Jetorific/modularFeedbackProcessor/README.md

# modularFeedbackProcessor
A Eurorack module that delays audio and allows the user to have their own custom effects in the feedback path. All analog design.
