Jetorific/modularFeedbackProcessor/modularFeedbackProcessor/modularFeedbackProcessor.kicad_pcb

## KiCad design modularFeedbackProcessor/modularFeedbackProcessor.kicad_pcb (2026-04-29)

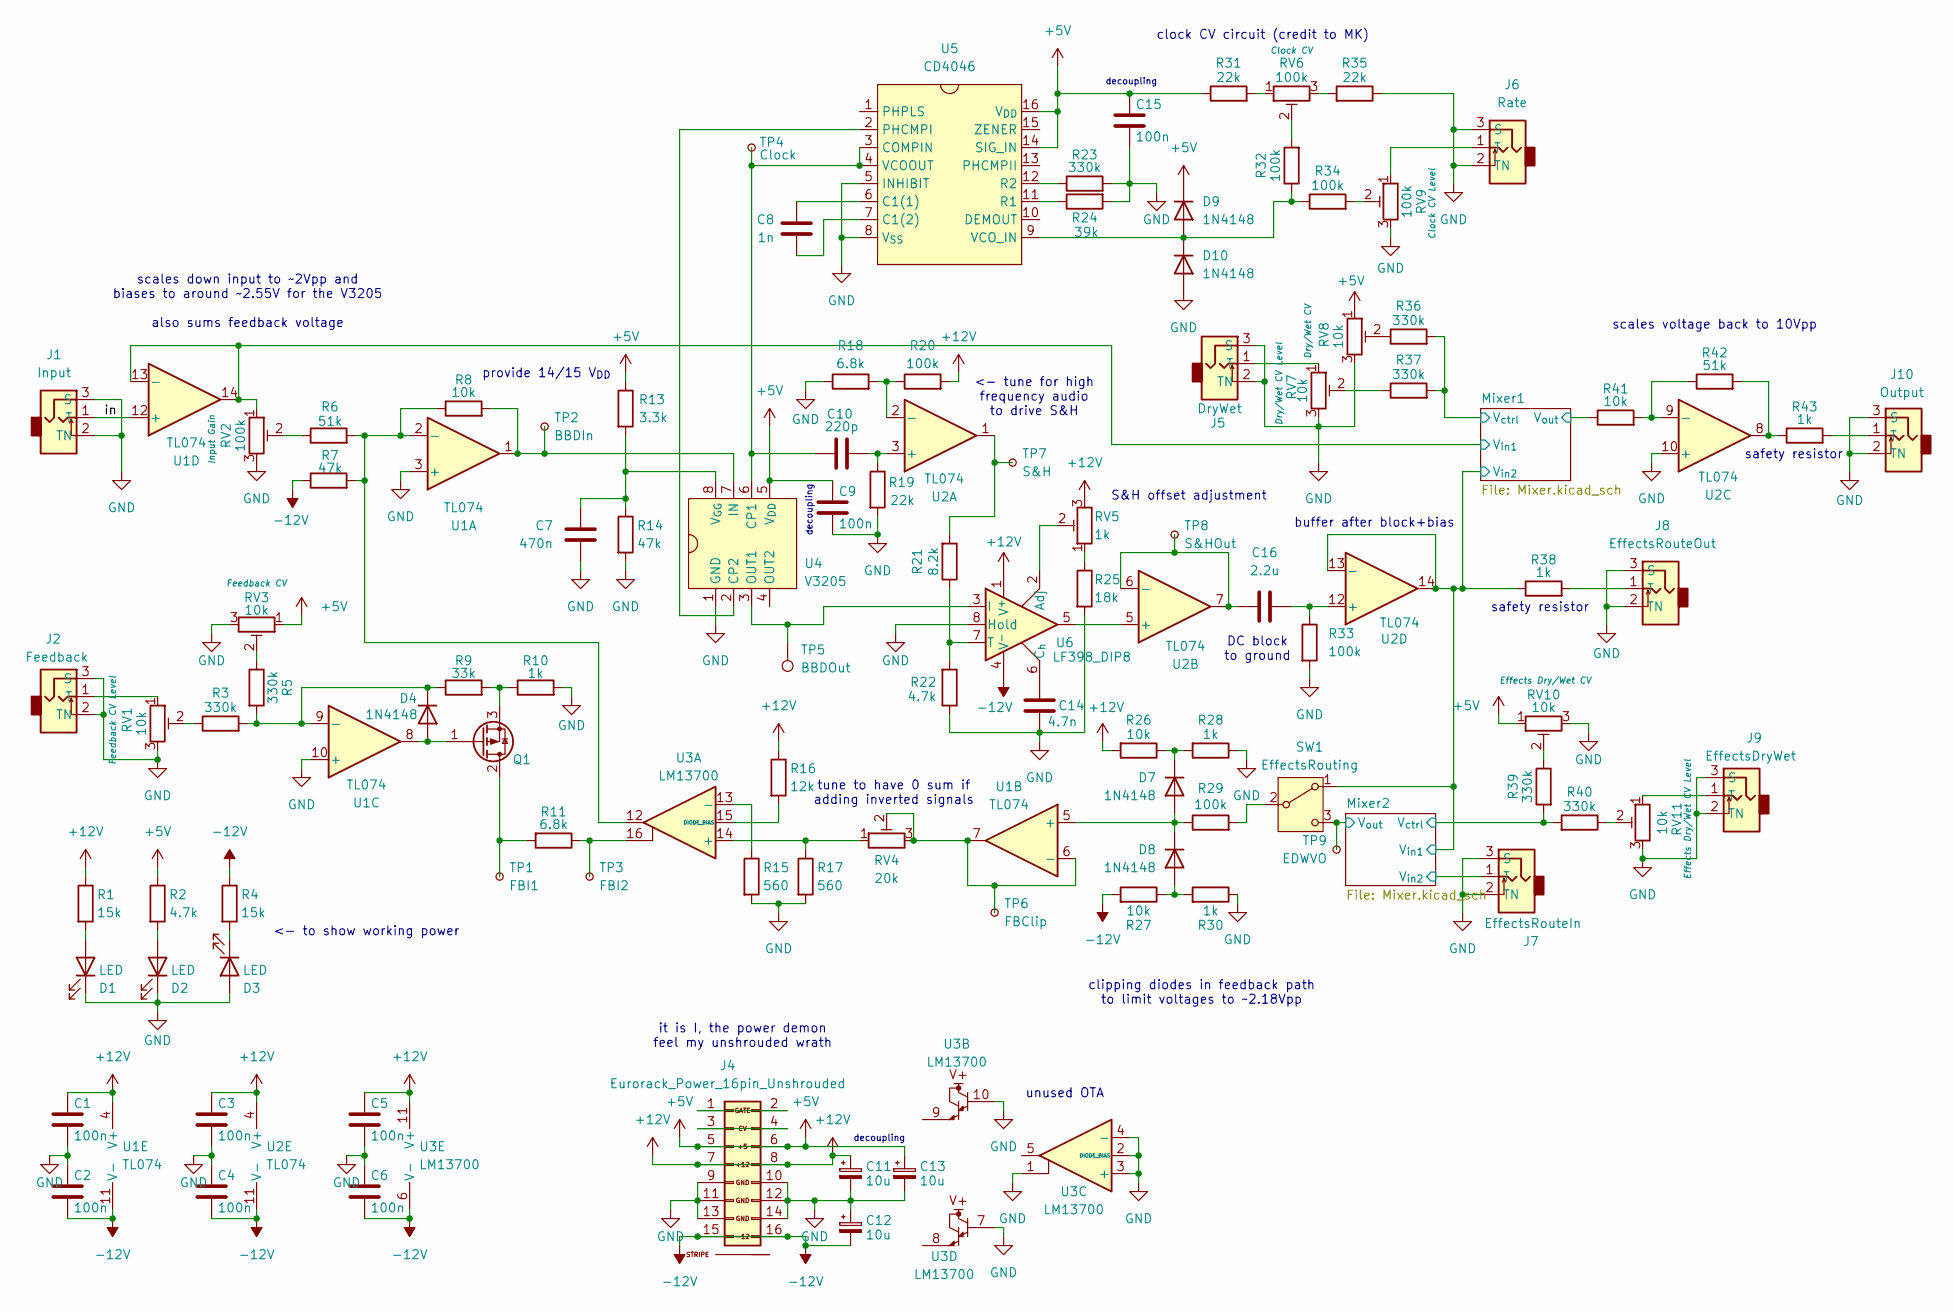
[picture p4: schematic modularFeedbackProcessor.kicad_sch, Modular Feedback Processor]

Parts:
C1, C2, C3, C4, C5, C6, C9, C15: 100n; C_0805_2012Metric_Pad1.18x1.45mm_HandSolder
C7: 470n; C_0805_2012Metric_Pad1.18x1.45mm_HandSolder
C8: 1n; C_0805_2012Metric_Pad1.18x1.45mm_HandSolder
C10: 220p; C_0805_2012Metric_Pad1.18x1.45mm_HandSolder
C11, C12, C13: 10u; CP_Radial_D5.0mm_P2.00mm
C14: 4.7n; C_0805_2012Metric_Pad1.18x1.45mm_HandSolder
C16: 2.2u; C_0805_2012Metric_Pad1.18x1.45mm_HandSolder
D1, D2, D3: LED; LED_D5.0mm
D4, D7, D8, D9, D10: 1N4148; D_DO-35_SOD27_P7.62mm_Horizontal
J1: Input; PJ301M-12
J2: Feedback; PJ301M-12
J4: Eurorack_Power_16pin_Unshrouded; Pins_2x08_2.54mm_TH_EuroPower; Part Number 1-1602FBV0T
J5: DryWet; PJ301M-12
J6: Rate; PJ301M-12
J7: EffectsRouteIn; PJ301M-12
J8: EffectsRouteOut; PJ301M-12
J9: EffectsDryWet; PJ301M-12
J10: Output; PJ301M-12
Q1: Q_PMOS_GDS; TO-220-3_Vertical
R1, R4: 15k; R_0805_2012Metric_Pad1.20x1.40mm_HandSolder
R2, R22: 4.7k; R_0805_2012Metric_Pad1.20x1.40mm_HandSolder
R3, R5, R23, R36, R37, R39, R40: 330k; R_0805_2012Metric_Pad1.20x1.40mm_HandSolder
R6, R42: 51k; R_0805_2012Metric_Pad1.20x1.40mm_HandSolder
R7, R14: 47k; R_0805_2012Metric_Pad1.20x1.40mm_HandSolder
R8, R26, R27, R41: 10k; R_0805_2012Metric_Pad1.20x1.40mm_HandSolder
R9: 33k; R_0805_2012Metric_Pad1.20x1.40mm_HandSolder
R10, R28, R30, R38, R43: 1k; R_0805_2012Metric_Pad1.20x1.40mm_HandSolder
R11, R18: 6.8k; R_0805_2012Metric_Pad1.20x1.40mm_HandSolder
R13: 3.3k; R_0805_2012Metric_Pad1.20x1.40mm_HandSolder
R15, R17: 560; R_0805_2012Metric_Pad1.20x1.40mm_HandSolder
R16: 12k; R_0805_2012Metric_Pad1.20x1.40mm_HandSolder
R19, R31, R35: 22k; R_0805_2012Metric_Pad1.20x1.40mm_HandSolder
R20, R29, R32, R33, R34: 100k; R_0805_2012Metric_Pad1.20x1.40mm_HandSolder
R21: 8.2k; R_0805_2012Metric_Pad1.20x1.40mm_HandSolder
R24: 39k; R_0805_2012Metric_Pad1.20x1.40mm_HandSolder
R25: 18k; R_0805_2012Metric_Pad1.20x1.40mm_HandSolder
RV1, RV3, RV7, RV8, RV10, RV11: 10k; Alpha9mmPot
RV2, RV6, RV9: 100k; Alpha9mmPot
RV4: 20k; Potentiometer_Vishay_T73XW_Horizontal
RV5: 1k; Potentiometer_Vishay_T73XW_Horizontal
SW1: EffectsRouting; Switch_Toggle_SPDT_SubMini
TP1: FBI1; TestPoint_Pad_06
TP2: BBDIn; TestPoint_Pad_06
TP3: FBI2; TestPoint_Pad_06
TP4: Clock; TestPoint_Pad_06
TP5: BBDOut; TestPoint_Pad_06
TP6: FBClip; TestPoint_Pad_06
TP7: S&H; TestPoint_Pad_06
TP8: S&HOut; TestPoint_Pad_06
TP9: EDWVO; TestPoint_Pad_06
U1, U2: TL074; DIP-14_W7.62mm_LongPads
U3: LM13700; DIP-16_W7.62mm_LongPads
U4: V3205; DIP-14_W7.62mm_LongPads_8pin
U5: CD4046; DIP-16_W7.62mm_LongPads
U6: LF398_DIP8; DIP-8_W7.62mm

Connections:
+5V: C9.1, C13.1, C15.1, D9.1 (K), J4.5 (+12V), J4.6, R2.1, R13.1, R31.1, RV3.1, RV8.1, RV10.1, U4.5 (V_{DD}), U5.14 (SIG_IN), U5.16 (V_{DD})
+12V: C1.1, C3.1, C5.1, C11.1, J4.7 (12V), J4.8 (+12V), R1.1, R16.1, R20.2, R26.2, RV5.3, U1.4 (V+), U2.4 (V+), U3.11 (V+), U6.1 (V^{+}); also elsewhere on the board
-12V: C2.2, C4.2, C6.2, C12.2, J4.15 (-12V), J4.16, R4.1, R7.1, R27.2, U1.11 (V-), U2.11 (V-), U3.6 (V-), U6.4 (V^{-}); also elsewhere on the board
/Mixer1/V_{ctrl}: R36.2, R37.2; also elsewhere on the board
/Mixer1/V_{in1}: RV2.1, U1.13 (-), U1.14; also elsewhere on the board
/Mixer1/V_{in2}: R38.1, SW1.1 (A), U2.13 (-), U2.14; also elsewhere on the board
/Mixer1/V_{out}: R41.1; also elsewhere on the board
/Mixer2/V_{ctrl}: R39.2, R40.2; also elsewhere on the board
/Mixer2/V_{in2}: J7.1 (T); also elsewhere on the board
/Mixer2/V_{out}: SW1.3 (C), TP9.1 (1_1); also elsewhere on the board
/in: J1.1 (T), U1.12 (+)
GND: C1.2, C2.1, C3.2, C4.1, C5.2, C6.1, C7.2, C9.2, C11.2, C12.1, C13.2, C14.2, C15.2, D1.1 (K), D2.1 (K), D3.2 (A), D10.2 (A), J1.2 (TN), J1.3 (S), J2.2 (TN), J2.3 (S), J4.9 (GND), J4.10 (GND), J4.11 (GND), J4.12 (GND), J4.13 (-12), J4.14 (-12V), J5.2 (TN), J5.3 (S), J6.2 (TN), J6.3 (S), J7.2 (TN), J7.3 (S), J8.2 (TN), J8.3 (S), J9.2 (TN), J9.3 (S), J10.2 (TN), J10.3 (S), R10.2, R14.2, R15.2, R17.2, R18.1, R19.2, R22.1, R23.2, R24.2, R25.2, R28.1, R30.1, R33.2, R35.1, RV1.3, RV2.3, RV3.3, RV7.3, RV8.3, RV9.3, RV10.3, RV11.3, U1.3 (+), U1.10 (+), U2.10 (+), U3.1, U3.2 (DIODE_BIAS), U3.3 (+), U3.4 (-), U3.7, U3.10, U4.1 (GND), U5.5 (INHIBIT), U5.8 (V_{SS}), U6.8 (Hold); also elsewhere on the board
unnamed: D1.2 (A), R1.2
unnamed: D2.2 (A), R2.2
unnamed: D3.1 (K), R4.2
unnamed: D4.2 (A), Q1.1 (G), U1.8
unnamed: D4.1 (K), R3.2, R5.2, R9.1, U1.9 (-)
unnamed: D7.2 (A), D8.1 (K), R29.1, U1.5 (+)
unnamed: D7.1 (K), R26.1, R28.2
unnamed: D8.2 (A), R27.1, R30.2
unnamed: D9.2 (A), D10.1 (K), R32.1, R34.1, U5.9 (VCO_IN)
unnamed: J2.1 (T), RV1.1
unnamed: J4.1, J4.2
unnamed: J4.3, J4.4
unnamed: J5.1 (T), RV7.1
unnamed: J6.1 (T), RV9.1
unnamed: J8.1 (T), R38.2
unnamed: J9.1 (T), RV11.1
unnamed: J10.1 (T), R43.2
unnamed: Q1.2 (D), R11.2, TP1.1 (1_1)
unnamed: Q1.3 (S), R9.2, R10.1
unnamed: R3.1, RV1.2
unnamed: R5.1, RV3.2
unnamed: R6.1, RV2.2
unnamed: R11.1, TP3.1 (1_1), U3.16
unnamed: R21.2, TP7.1 (1_1), U2.1
unnamed: R25.1, RV5.1
unnamed: R31.2, RV6.1
unnamed: R32.2, RV6.2
unnamed: R34.2, RV9.2
unnamed: R35.2, RV6.3
unnamed: R36.1, RV8.2
unnamed: R37.1, RV7.2
unnamed: R39.1, RV10.2
unnamed: R40.1, RV11.2
unnamed: R42.2, R43.1, U2.8
unnamed: R29.2, SW1.2 (B)
unnamed: R6.2, R7.2, R8.1, U1.2 (-), U3.12
unnamed: RV4.2, RV4.3, TP6.1 (1_1), U1.6 (-), U1.7
unnamed: C10.2, R19.1, U2.3 (+)
unnamed: R18.2, R20.1, U2.2 (-)
unnamed: U2.5 (+), U6.5
unnamed: C16.2, TP8.1 (1_1), U2.6 (-), U2.7
unnamed: R41.2, R42.1, U2.9 (-)
unnamed: C16.1, R33.1, U2.12 (+)
unnamed: R17.1, RV4.1, U3.14 (+)
unnamed: R15.1, U3.13 (-)
unnamed: R16.2, U3.15 (DIODE_BIAS)
unnamed: C10.1, TP4.1 (1_1), U4.6 (CP1), U5.3 (COMPIN), U5.4 (VCOOUT)
unnamed: U4.2 (CP2), U5.2 (PHCMPI)
unnamed: R8.2, TP2.1 (1_1), U1.1, U4.7 (IN)
unnamed: TP5.1 (1_1), U4.3 (OUT1), U6.3 (I)
unnamed: C7.1, R13.2, R14.1, U4.8 (V_{GG})
unnamed: C8.1, U5.6 (C1(1))
unnamed: C8.2, U5.7 (C1(2))
unnamed: R24.1, U5.11 (R1)
unnamed: R23.1, U5.12 (R2)
unnamed: RV5.2, U6.2 (Adj)
unnamed: C14.1, U6.6 (C_{h})
unnamed: R21.1, R22.2, U6.7 (T)

Notes on the sheet:
<- tune for high frequency audio to drive S&H
it is I, the power demon feel my unshrouded wrath
safety resistor
clock CV circuit (credit to MK)
unused OTA
clipping diodes in feedback path to limit voltages to ~2.18Vpp
decoupling
DC block to ground
scales voltage back to 10Vpp
<- to show working power
provide 14/15 V_{DD}
S&H offset adjustment
tune to have 0 sum if adding inverted signals
scales down input to ~2Vpp and biases to around ~2.55V for the V3205 also sums feedback voltage
buffer after block+bias

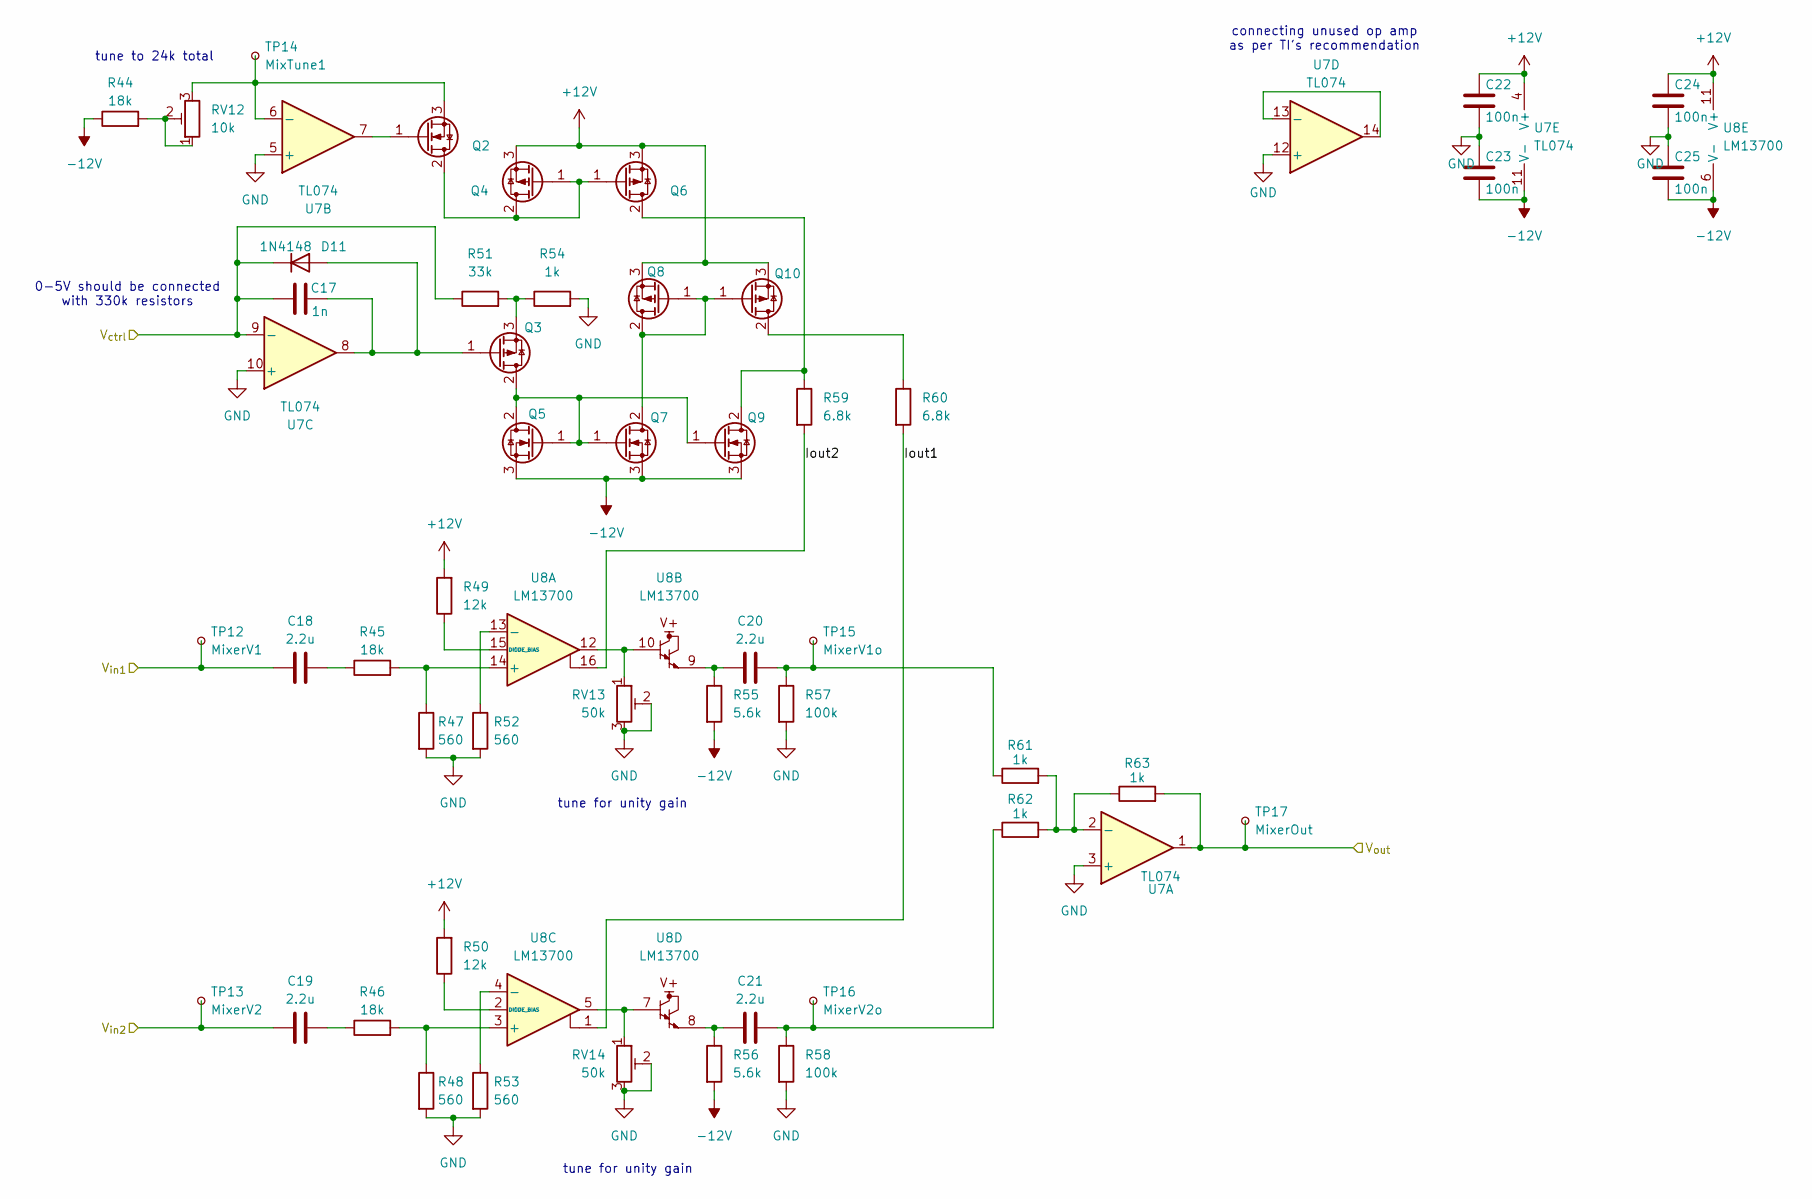
[picture p5: schematic Mixer.kicad_sch]

Parts:
C17: 1n; C_0805_2012Metric_Pad1.18x1.45mm_HandSolder
C18, C19, C20, C21: 2.2u; C_0805_2012Metric_Pad1.18x1.45mm_HandSolder
C22, C23, C24, C25: 100n; C_0805_2012Metric_Pad1.18x1.45mm_HandSolder
D11: 1N4148; D_DO-35_SOD27_P7.62mm_Horizontal
Q2, Q5, Q7, Q9: Q_NMOS_GDS; TO-220-3_Vertical
Q3, Q4, Q6, Q8, Q10: Q_PMOS_GDS; TO-220-3_Vertical
R44, R45, R46: 18k; R_0805_2012Metric_Pad1.20x1.40mm_HandSolder
R47, R48, R52, R53: 560; R_0805_2012Metric_Pad1.20x1.40mm_HandSolder
R49, R50: 12k; R_0805_2012Metric_Pad1.20x1.40mm_HandSolder
R51: 33k; R_0805_2012Metric_Pad1.20x1.40mm_HandSolder
R54, R61, R62, R63: 1k; R_0805_2012Metric_Pad1.20x1.40mm_HandSolder
R55, R56: 5.6k; R_0805_2012Metric_Pad1.20x1.40mm_HandSolder
R57, R58: 100k; R_0805_2012Metric_Pad1.20x1.40mm_HandSolder
R59, R60: 6.8k; R_0805_2012Metric_Pad1.20x1.40mm_HandSolder
RV12: 10k; Potentiometer_Vishay_T73XW_Horizontal
RV13, RV14: 50k; Potentiometer_Vishay_T73XW_Horizontal
TP12: MixerV1; TestPoint_Pad_06
TP13: MixerV2; TestPoint_Pad_06
TP14: MixTune1; TestPoint_Pad_06
TP15: MixerV1o; TestPoint_Pad_06
TP16: MixerV2o; TestPoint_Pad_06
TP17: MixerOut; TestPoint_Pad_06
U7: TL074; DIP-14_W7.62mm_LongPads
U8: LM13700; DIP-16_W7.62mm_LongPads

Connections:
+12V: C22.1, C24.1, Q4.3 (S), Q6.3 (S), Q8.3 (S), Q10.3 (S), R49.2, R50.2, U7.4 (V+), U8.11 (V+); also elsewhere on the board
-12V: C23.2, C25.2, Q5.3 (S), Q7.3 (S), Q9.3 (S), R44.1, R55.2, R56.2, U7.11 (V-), U8.6 (V-); also elsewhere on the board
/Mixer1/Iout1: R60.2, U8.1
/Mixer1/Iout2: R59.2, U8.16
/Mixer1/V_{ctrl}: C17.2, D11.1 (K), R51.1, U7.9 (-); also elsewhere on the board
/Mixer1/V_{in1}: C18.1, TP12.1 (1_1); also elsewhere on the board
/Mixer1/V_{in2}: C19.1, TP13.1 (1_1); also elsewhere on the board
/Mixer1/V_{out}: R63.2, TP17.1 (1_1), U7.1; also elsewhere on the board
GND: C22.2, C23.1, C24.2, C25.1, R47.2, R48.2, R52.2, R53.2, R54.2, R57.2, R58.2, RV13.2, RV13.3, RV14.2, RV14.3, U7.3 (+), U7.5 (+), U7.10 (+), U7.12 (+); also elsewhere on the board
unnamed: C18.2, R45.1
unnamed: C19.2, R46.1
unnamed: C20.1, R55.1, U8.9
unnamed: C20.2, R57.1, R61.1, TP15.1 (1_1)
unnamed: C21.1, R56.1, U8.8
unnamed: C21.2, R58.1, R62.1, TP16.1 (1_1)
unnamed: C17.1, D11.2 (A), Q3.1 (G), U7.8
unnamed: Q2.2 (D), Q4.1 (G), Q4.2 (D), Q6.1 (G)
unnamed: Q2.1 (G), U7.7
unnamed: Q2.3 (S), RV12.3, TP14.1 (1_1), U7.6 (-)
unnamed: Q3.2 (D), Q5.1 (G), Q5.2 (D), Q7.1 (G), Q9.1 (G)
unnamed: Q3.3 (S), R51.2, R54.1
unnamed: Q6.2 (D), Q9.2 (D), R59.1
unnamed: Q10.2 (D), R60.1
unnamed: Q7.2 (D), Q8.1 (G), Q8.2 (D), Q10.1 (G)
unnamed: R44.2, RV12.1, RV12.2
unnamed: RV13.1, U8.10, U8.12
unnamed: RV14.1, U8.5, U8.7
unnamed: R61.2, R62.2, R63.1, U7.2 (-)
unnamed: U7.13 (-), U7.14
unnamed: R45.2, R47.1, U8.14 (+)
unnamed: R52.1, U8.13 (-)
unnamed: R49.1, U8.15 (DIODE_BIAS)
unnamed: R46.2, R48.1, U8.3 (+)
unnamed: R53.1, U8.4 (-)
unnamed: R50.1, U8.2 (DIODE_BIAS)

Parts of its further copies:
C26: 1n; C_0805_2012Metric_Pad1.18x1.45mm_HandSolder
C27, C28, C29, C30: 2.2u; C_0805_2012Metric_Pad1.18x1.45mm_HandSolder
C31, C32, C33, C34: 100n; C_0805_2012Metric_Pad1.18x1.45mm_HandSolder
D12: 1N4148; D_DO-35_SOD27_P7.62mm_Horizontal
Q11, Q14, Q16, Q18: Q_NMOS_GDS; TO-220-3_Vertical
Q12, Q13, Q15, Q17, Q19: Q_PMOS_GDS; TO-220-3_Vertical
R64, R65, R66: 18k; R_0805_2012Metric_Pad1.20x1.40mm_HandSolder
R67, R68, R72, R73: 560; R_0805_2012Metric_Pad1.20x1.40mm_HandSolder
R69, R70: 12k; R_0805_2012Metric_Pad1.20x1.40mm_HandSolder
R71: 33k; R_0805_2012Metric_Pad1.20x1.40mm_HandSolder
R74, R81, R82, R83: 1k; R_0805_2012Metric_Pad1.20x1.40mm_HandSolder
R75, R76: 5.6k; R_0805_2012Metric_Pad1.20x1.40mm_HandSolder
R77, R78: 100k; R_0805_2012Metric_Pad1.20x1.40mm_HandSolder
R79, R80: 6.8k; R_0805_2012Metric_Pad1.20x1.40mm_HandSolder
RV15: 10k; Potentiometer_Vishay_T73XW_Horizontal
RV16, RV17: 50k; Potentiometer_Vishay_T73XW_Horizontal
TP18: MixerV1; TestPoint_Pad_06
TP19: MixerV2; TestPoint_Pad_06
TP20: MixTune1; TestPoint_Pad_06
TP21: MixerV1o; TestPoint_Pad_06
TP22: MixerV2o; TestPoint_Pad_06
TP23: MixerOut; TestPoint_Pad_06
U9: TL074; DIP-14_W7.62mm_LongPads
U10: LM13700; DIP-16_W7.62mm_LongPads

Connections of its further copies:
+12V: C31.1, C33.1, Q13.3 (S), Q15.3 (S), Q17.3 (S), Q19.3 (S), R69.2, R70.2, U9.4 (V+), U10.11 (V+); also elsewhere on the board
-12V: C32.2, C34.2, Q14.3 (S), Q16.3 (S), Q18.3 (S), R64.1, R75.2, R76.2, U9.11 (V-), U10.6 (V-); also elsewhere on the board
/Mixer1/V_{in2}: C27.1, TP18.1 (1_1); also elsewhere on the board
/Mixer2/Iout1: R80.2, U10.1
/Mixer2/Iout2: R79.2, U10.16
/Mixer2/V_{ctrl}: C26.2, D12.1 (K), R71.1, U9.9 (-); also elsewhere on the board
/Mixer2/V_{in2}: C28.1, TP19.1 (1_1); also elsewhere on the board
/Mixer2/V_{out}: R83.2, TP23.1 (1_1), U9.1; also elsewhere on the board
GND: C31.2, C32.1, C33.2, C34.1, R67.2, R68.2, R72.2, R73.2, R74.2, R77.2, R78.2, RV16.2, RV16.3, RV17.2, RV17.3, U9.3 (+), U9.5 (+), U9.10 (+), U9.12 (+); also elsewhere on the board
unnamed: C27.2, R65.1
unnamed: C28.2, R66.1
unnamed: C29.1, R75.1, U10.9
unnamed: C29.2, R77.1, R81.1, TP21.1 (1_1)
unnamed: C30.1, R76.1, U10.8
unnamed: C30.2, R78.1, R82.1, TP22.1 (1_1)
unnamed: C26.1, D12.2 (A), Q12.1 (G), U9.8
unnamed: Q11.2 (D), Q13.1 (G), Q13.2 (D), Q15.1 (G)
unnamed: Q11.1 (G), U9.7
unnamed: Q11.3 (S), RV15.3, TP20.1 (1_1), U9.6 (-)
unnamed: Q12.2 (D), Q14.1 (G), Q14.2 (D), Q16.1 (G), Q18.1 (G)
unnamed: Q12.3 (S), R71.2, R74.1
unnamed: Q15.2 (D), Q18.2 (D), R79.1
unnamed: Q16.2 (D), Q17.1 (G), Q17.2 (D), Q19.1 (G)
unnamed: Q19.2 (D), R80.1
unnamed: R64.2, RV15.1, RV15.2
unnamed: RV16.1, U10.10, U10.12
unnamed: RV17.1, U10.5, U10.7
unnamed: R81.2, R82.2, R83.1, U9.2 (-)
unnamed: U9.13 (-), U9.14
unnamed: R65.2, R67.1, U10.14 (+)
unnamed: R72.1, U10.13 (-)
unnamed: R69.1, U10.15 (DIODE_BIAS)
unnamed: R66.2, R68.1, U10.3 (+)
unnamed: R73.1, U10.4 (-)
unnamed: R70.1, U10.2 (DIODE_BIAS)

Notes on the sheet:
tune for unity gain
connecting unused op amp as per TI's recommendation
tune to 24k total
0-5V should be connected with 330k resistors

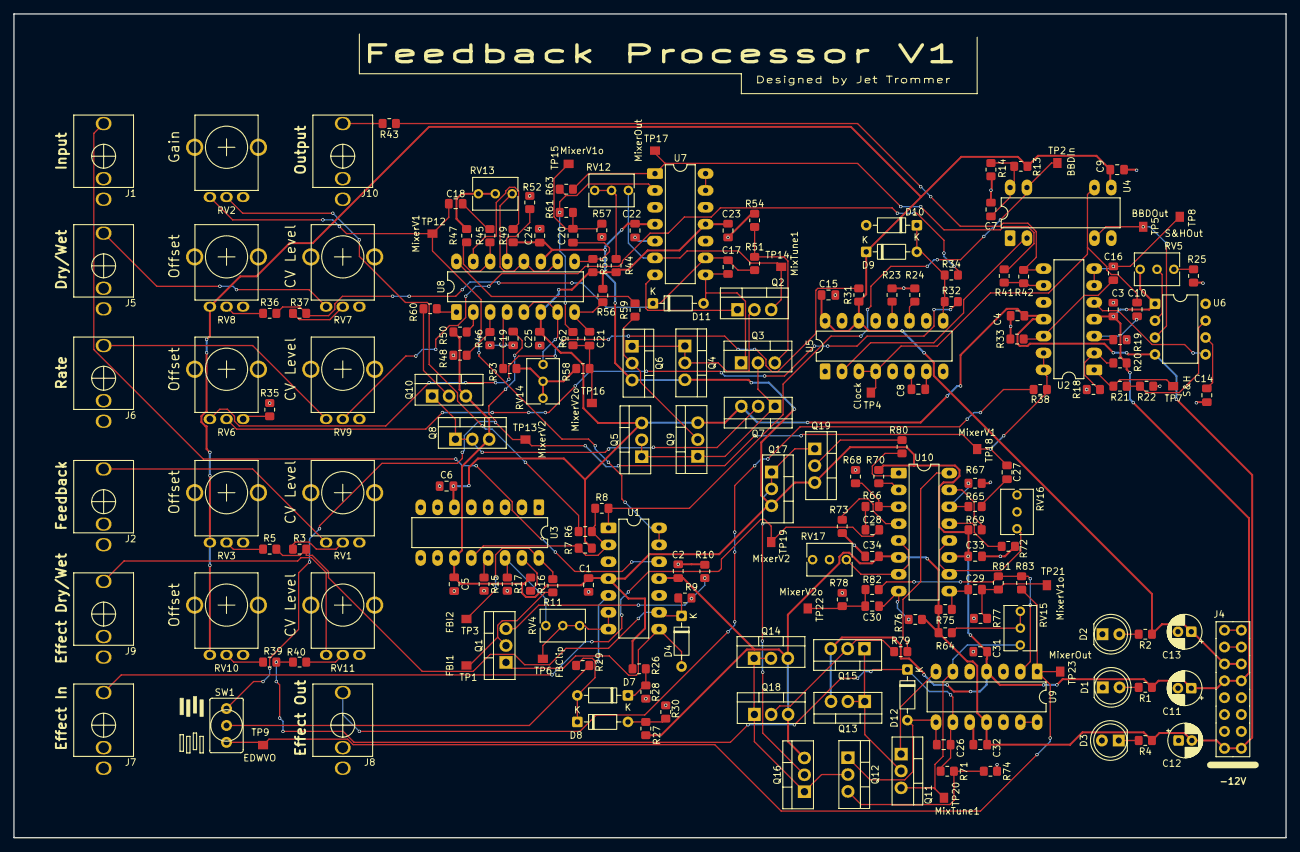
[picture p6: board modularFeedbackProcessor.kicad_pcb from above]

Board: 2 copper layers, 191.5 x 124.0 mm, 203 parts (0 on the bottom side), 126 nets.
