Jetorific/modularFeedbackProcessor/modularFeedbackProcessor/MFP.kicad_blocks/Mixer.kicad_block/Mixer.kicad_pcb

## KiCad design modularFeedbackProcessor/MFP.kicad_blocks/Mixer.kicad_block/Mixer.kicad_pcb (2026-04-23)

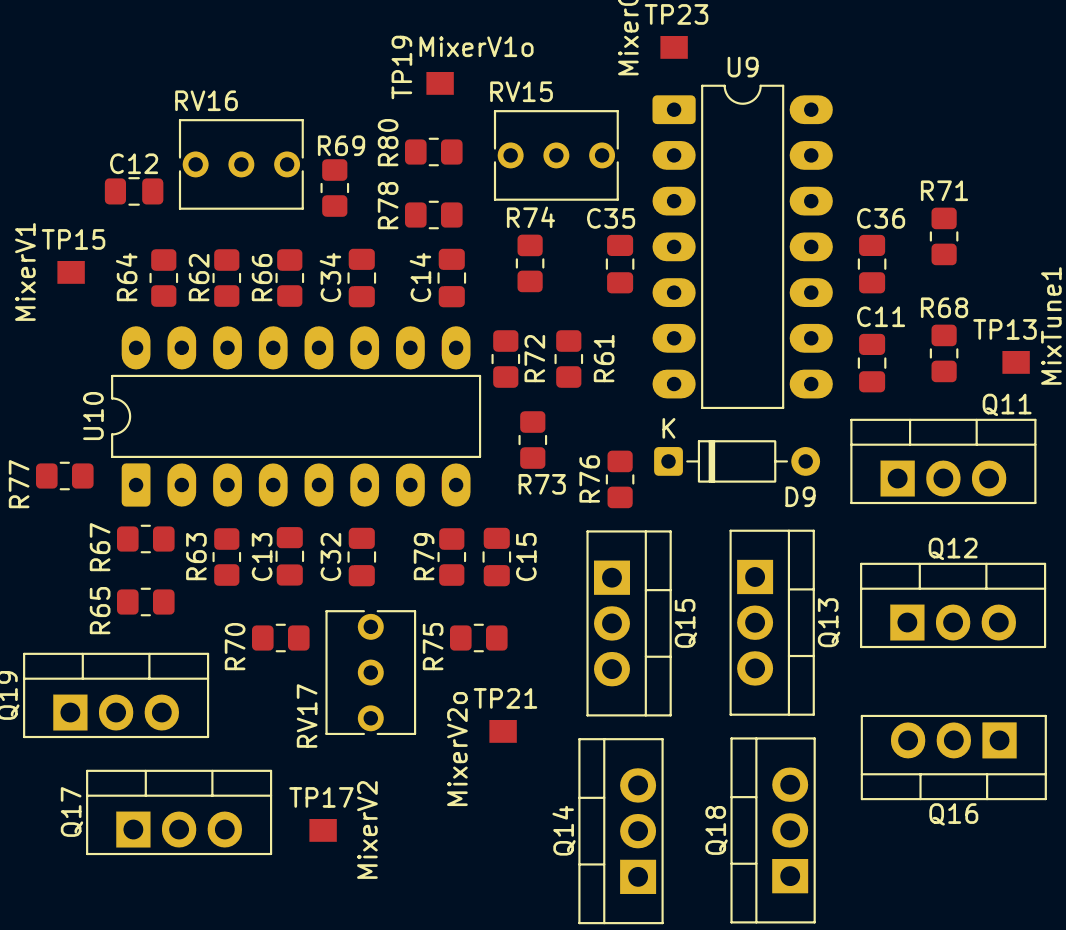
[picture p7: board Mixer.kicad_pcb from above]

Board: 4 copper layers, 50 parts (0 on the bottom side), 35 nets, no tracks yet.

Parts:
C11: 1n; C_0805_2012Metric_Pad1.18x1.45mm_HandSolder
C12, C13, C14, C15: 2.2u; C_0805_2012Metric_Pad1.18x1.45mm_HandSolder
C32, C34, C35, C36: 100n; C_0805_2012Metric_Pad1.18x1.45mm_HandSolder
D9: 1N4148; D_DO-35_SOD27_P7.62mm_Horizontal
Q11, Q14, Q16, Q18: Q_NMOS_GDS; TO-220-3_Vertical
Q12, Q13, Q15, Q17, Q19: Q_PMOS_GDS; TO-220-3_Vertical
R61, R62, R63: 18k; R_0805_2012Metric_Pad1.20x1.40mm_HandSolder
R64, R65, R69, R70: 560; R_0805_2012Metric_Pad1.20x1.40mm_HandSolder
R66, R67: 12k; R_0805_2012Metric_Pad1.20x1.40mm_HandSolder
R68: 33k; R_0805_2012Metric_Pad1.20x1.40mm_HandSolder
R71, R78, R79, R80: 1k; R_0805_2012Metric_Pad1.20x1.40mm_HandSolder
R72, R73: 5.6k; R_0805_2012Metric_Pad1.20x1.40mm_HandSolder
R74, R75: 100k; R_0805_2012Metric_Pad1.20x1.40mm_HandSolder
R76, R77: 6.8k; R_0805_2012Metric_Pad1.20x1.40mm_HandSolder
RV15: 10k; Potentiometer_Vishay_T73XW_Horizontal
RV16, RV17: 50k; Potentiometer_Vishay_T73XW_Horizontal
TP13: MixTune1; TestPoint_Pad_06
TP15: MixerV1; TestPoint_Pad_06
TP17: MixerV2; TestPoint_Pad_06
TP19: MixerV1o; TestPoint_Pad_06
TP21: MixerV2o; TestPoint_Pad_06
TP23: MixerOut; TestPoint_Pad_06
U9: TL074; DIP-14_W7.62mm_LongPads
U10: LM13700; DIP-16_W7.62mm_LongPads

Connections:
+12V: C34.1, C35.1, Q13.3 (S), Q15.3 (S), Q17.3 (S), Q19.3 (S), R66.2, R67.2, U9.4 (V+), U10.11 (V+)
-12V: C32.2, C36.2, Q14.3 (S), Q16.3 (S), Q18.3 (S), R61.1, R72.2, R73.2, U9.11 (V-), U10.6 (V-)
/DryWet Mixer/V_{in2}: C12.1, TP15.1 (1_1)
/Effects Mixer/Iout1: R77.2, U10.1
/Effects Mixer/Iout2: R76.2, U10.16
/Effects Mixer/V_{ctrl}: C11.2, D9.1 (K), R68.1, U9.9 (-)
/Effects Mixer/V_{in2}: C13.1, TP17.1 (1_1)
/Effects Mixer/V_{out}: R80.2, TP23.1 (1_1), U9.1
GND: C32.1, C34.2, C35.2, C36.1, R64.2, R65.2, R69.2, R70.2, R71.2, R74.2, R75.2, RV16.2, RV16.3, RV17.2, RV17.3, U9.3 (+), U9.5 (+), U9.10 (+), U9.12 (+)
unnamed: C12.2, R62.1
unnamed: C13.2, R63.1
unnamed: C14.1, R72.1, U10.9
unnamed: C14.2, R74.1, R78.1, TP19.1 (1_1)
unnamed: C15.1, R73.1, U10.8
unnamed: C15.2, R75.1, R79.1, TP21.1 (1_1)
unnamed: C11.1, D9.2 (A), Q12.1 (G), U9.8
unnamed: Q11.2 (D), Q13.1 (G), Q13.2 (D), Q15.1 (G)
unnamed: Q11.1 (G), U9.7
unnamed: Q11.3 (S), RV15.3, TP13.1 (1_1), U9.6 (-)
unnamed: Q12.2 (D), Q14.1 (G), Q14.2 (D), Q16.1 (G), Q18.1 (G)
unnamed: Q12.3 (S), R68.2, R71.1
unnamed: Q15.2 (D), Q18.2 (D), R76.1
unnamed: Q16.2 (D), Q17.1 (G), Q17.2 (D), Q19.1 (G)
unnamed: Q19.2 (D), R77.1
unnamed: R61.2, RV15.1, RV15.2
unnamed: RV16.1, U10.10, U10.12
unnamed: RV17.1, U10.5, U10.7
unnamed: R78.2, R79.2, R80.1, U9.2 (-)
unnamed: U9.13 (-), U9.14
unnamed: R62.2, R64.1, U10.14 (+)
unnamed: R69.1, U10.13 (-)
unnamed: R66.1, U10.15 (DIODE_BIAS)
unnamed: R63.2, R65.1, U10.3 (+)
unnamed: R70.1, U10.4 (-)
unnamed: R67.1, U10.2 (DIODE_BIAS)
