Jetorific/modularFeedbackProcessor/(commit log)

2026-04-04 Added linked mixer submodule.
    [linkedMixer.kicad_sch, modularFeedbackProcessor.kicad_sch, power.kicad_sch]
2026-04-04 Scaling down input from 10Vpp to 1Vpp
    [linkedMixer.kicad_sch, modularFeedbackProcessor.kicad_sch]
2026-04-07 added basic CV control for single linked mixer
    [linkedMixer.kicad_sch, modularFeedbackProcessor.kicad_sch]
2026-04-07 Minor changes + clock CV rework based on Moritz Klein's work
    [modularFeedbackProcessor.kicad_sch, power.kicad_sch]
2026-04-07 some CV work
    [modularFeedbackProcessor.kicad_sch]
2026-04-07 last lab changes. slightly more text
    [modularFeedbackProcessor.kicad_sch]
2026-04-15 committing from macbook, KiCad 10.0
2026-04-21 feedback path completed without effects routing
    [linkedMixer.kicad_sch, modularFeedbackProcessor.kicad_sch, power.kicad_sch]
2026-04-21 basically finished the thing? added full feedback path. all jacks are routed (except for double)
    [linkedMixer.kicad_sch, modularFeedbackProcessor.kicad_sch, power.kicad_sch]
2026-04-21 more fixes, touch ups. implemented rescaling of the output.
    [modularFeedbackProcessor.kicad_sch]
2026-04-21 added switch to turn on/off effect routing
    [modularFeedbackProcessor.kicad_sch]
2026-04-22 pushing changes
    [linkedMixer.kicad_sch, modularFeedbackProcessor.kicad_sch]
2026-04-22 fixed 6.8k resistor location in feedback VCA
    [modularFeedbackProcessor.kicad_sch]
2026-04-22 last commit before attempting to change the S&H to the LF398
    [modularFeedbackProcessor.kicad_sch]
2026-04-22 added all footprints, beginning to work on ERC errors
    [linkedMixer.kicad_sch, modularFeedbackProcessor.kicad_sch]
2026-04-23 lots of friggin progress. finished footprint work, and have just finished grouping. Now I will start to connect each group internally.
    [linkedMixer.kicad_sch, modularFeedbackProcessor.kicad_pcb, modularFeedbackProcessor.kicad_sch]
2026-04-23 save before i mess something up
    [Mixer.kicad_pcb, Mixer.kicad_sch, modularFeedbackProcessor.kicad_pcb, modularFeedbackProcessor.kicad_sch]
2026-04-23 Update: did not destroy everything
    [Mixer.kicad_pcb, Mixer.kicad_sch, modularFeedbackProcessor.kicad_sch]
2026-04-23 layout mostly down. Going to begin routing
    [modularFeedbackProcessor.kicad_pcb, modularFeedbackProcessor.kicad_sch]
2026-04-23 routed power, good start
    [modularFeedbackProcessor.kicad_pcb]
2026-04-23 mostly done with the BBD module routing
    [modularFeedbackProcessor.kicad_pcb]
2026-04-23 significant progress
    [modularFeedbackProcessor.kicad_pcb, modularFeedbackProcessor.kicad_sch]
2026-04-23 first version to pass DRC
    [modularFeedbackProcessor.kicad_pcb]
2026-04-23 save before 220 class
    [modularFeedbackProcessor-B_Cu.gbr, modularFeedbackProcessor-B_Mask.gbr, modularFeedbackProcessor-B_Paste.gbr, modularFeedbackProcessor-B_Silkscreen.gbr, modularFeedbackProcessor-Edge_Cuts.gbr, modularFeedbackProcessor-F_Cu.gbr, modularFeedbackProcessor-F_Mask.gbr, modularFeedbackProcessor-F_Paste.gbr]
2026-04-23 forgot to save schematic
2026-04-23 finished final tweaks before JLC
    [modularFeedbackProcessor.kicad_pcb]
2026-04-23 oops final one
    [modularFeedbackProcessor-B_Cu.gbr, modularFeedbackProcessor-B_Mask.gbr, modularFeedbackProcessor-B_Paste.gbr, modularFeedbackProcessor-B_Silkscreen.gbr, modularFeedbackProcessor-Edge_Cuts.gbr, modularFeedbackProcessor-F_Cu.gbr, modularFeedbackProcessor-F_Mask.gbr, modularFeedbackProcessor-F_Paste.gbr]
2026-04-24 Fixed error with Q1. Drain/source were swapped. Unfortunately the PCB will not receive such fixing before it arrives.
    [modularFeedbackProcessor-B_Cu.gbl, modularFeedbackProcessor-B_Mask.gbs, modularFeedbackProcessor-B_Paste.gbp, modularFeedbackProcessor-B_Silkscreen.gbo, modularFeedbackProcessor-Edge_Cuts.gm1, modularFeedbackProcessor-F_Cu.gbr, modularFeedbackProcessor-F_Cu.gtl, modularFeedbackProcessor-F_Mask.gts]
2026-04-27 fixed Q1 on PCB.
    [modularFeedbackProcessor.kicad_pcb]
2026-04-29 fixed a few things
    [modularFeedbackProcessor.csv, modularFeedbackProcessor.kicad_pcb]
2026-04-30 Added DC blocking capacitor in S&H. Changed S&H sampling cap to 10n
    [modularFeedbackProcessor.kicad_sch]
2026-05-01 Added resistors for DC blocking cap. Added decoupling caps for LF398.
    [modularFeedbackProcessor.kicad_sch]
2026-05-01 swapped pins 7 and 8 of LF398
    [modularFeedbackProcessor.kicad_sch]
